blazjerman/ESP32-Based-Sensor-PCB/(commit log)

2025-01-21 Added buck converters.
    [ESP32-Based Sensor PCB.kicad_sch]
2025-01-21 Added rs485 ic and micro usb port.
    [ESP32-Based Sensor PCB.kicad_pcb, ESP32-Based Sensor PCB.kicad_sch]
2025-01-21 Added rs485 protection diodes
    [ESP32-Based Sensor PCB.kicad_sch, buck_3.3v.kicad_sch]
2025-01-21 Scheme done.
    [ESP32-Based Sensor PCB.kicad_pcb, ESP32-Based Sensor PCB.kicad_sch, buck_3.3v.kicad_sch, buck_5v.kicad_sch]
2025-01-22 Changed led resistor values and added jlcpcb fabrication.
    [ESP32-Based Sensor PCB.kicad_pcb, ESP32-Based Sensor PCB.kicad_sch]
2025-01-22 Added sound probe, 9v booster and change 3.3v buck to linear.
    [9V_Booster.kicad_sch, ESP32-Based Sensor PCB.kicad_pcb, ESP32-Based Sensor PCB.kicad_sch]
2025-01-22 The basic PCB wiring and layout have been completed.
    [9V_Booster.kicad_sch, ESP32-Based Sensor PCB.kicad_pcb, ESP32-Based Sensor PCB.kicad_sch]
2025-01-22 Changed the position of the 9V booster.
    [ESP32-Based Sensor PCB.kicad_pcb]
2025-01-22 Added 5v capacitor and improved 9v power line.
    [ESP32-Based Sensor PCB.kicad_pcb, ESP32-Based Sensor PCB.kicad_sch]
2025-01-22 Improved some power lanes.
    [ESP32-Based Sensor PCB.kicad_pcb]
2025-01-23 Added an electrolytic capacitor, one more RGB LED, and changed the booster position and traces.
    [9V_Booster.kicad_sch, ESP32-Based Sensor PCB.kicad_pcb, ESP32-Based Sensor PCB.kicad_sch]
2025-01-23 Fixed issues with the CH340C V3 connection pin and improved wiring.
    [ESP32-Based Sensor PCB.kicad_pcb, ESP32-Based Sensor PCB.kicad_sch]
2025-01-23 Added top gnd plane and fixed rgb led power problem.
    [9V_Booster.kicad_sch, ESP32-Based Sensor PCB.kicad_pcb, ESP32-Based Sensor PCB.kicad_sch]
2025-01-23 Fixed some pcb conection errors.
    [ESP32-Based Sensor PCB.kicad_pcb]
2025-01-23 Improved linear dropper heat dissipation and added the Innorenew logo.
    [ESP32-Based Sensor PCB.kicad_pcb]
2025-01-24 Fixed resistor size.
    [ESP32-Based Sensor PCB.kicad_pcb]
2025-01-24 Replaced the PNP transistor and added additional capacitors for improved stability.
    [ESP32-Based Sensor PCB.kicad_pcb, ESP32-Based Sensor PCB.kicad_sch]
2025-01-24 Improved wiring and added a USB input capacitor.
    [ESP32-Based Sensor PCB.kicad_pcb, ESP32-Based Sensor PCB.kicad_sch]
2025-01-25 Added light sensor.
    [ESP32-Based Sensor PCB.kicad_pcb, ESP32-Based Sensor PCB.kicad_sch]
2025-01-25 Change 9v booster inductor.
    [9V_Booster.kicad_sch, ESP32-Based Sensor PCB.kicad_pcb]
2025-01-25 Added 9V inductor footprint.
    [9V_Booster.kicad_sch, ESP32-Based Sensor PCB.kicad_pcb]
2025-01-25 Fixed USB differential pair.
    [ESP32-Based Sensor PCB.kicad_pcb, ESP32-Based Sensor PCB.kicad_sch]
2025-01-26 Mounting holes have been added.
    [ESP32-Based Sensor PCB.kicad_pcb, ESP32-Based Sensor PCB.kicad_sch]
2025-01-27 Made some changes and added JLC IDs to most parts.
    [9V_Booster.kicad_sch, ESP32-Based Sensor PCB.kicad_pcb, ESP32-Based Sensor PCB.kicad_sch]
2025-01-27 Change 9v booster.
    [9V_Booster.kicad_sch, ESP32-Based Sensor PCB.kicad_pcb]
2025-01-27 Improved some connections and added more labels.
    [ESP32-Based Sensor PCB.kicad_pcb]
2025-01-28 Corrected swapped wrong order of UART to RS485.
    [ESP32-Based Sensor PCB.kicad_pcb, ESP32-Based Sensor PCB.kicad_sch]
2025-01-28 Removed one RGB led.
    [ESP32-Based Sensor PCB.kicad_pcb, ESP32-Based Sensor PCB.kicad_sch]
2025-01-28 Changed some resistor values and fidex coil output.
    [9V_Booster.kicad_sch, ESP32-Based Sensor PCB.kicad_pcb, ESP32-Based Sensor PCB.kicad_sch]
2025-01-28 Changed some ics values.
    [9V_Booster.kicad_sch, ESP32-Based Sensor PCB.kicad_pcb, ESP32-Based Sensor PCB.kicad_sch]
2025-01-28 Changed RGB circuit.
    [ESP32-Based Sensor PCB.kicad_pcb, ESP32-Based Sensor PCB.kicad_sch]
2025-01-30 Changed serial pins and rgb led resistor.
    [ESP32-Based Sensor PCB.kicad_pcb, ESP32-Based Sensor PCB.kicad_sch]
2025-01-30 Added pcb test code.
    [ESP32-Based Sensor PCB.kicad_pcb]
2025-02-01 Changed rgb led resistor values
    [ESP32-Based Sensor PCB.kicad_pcb, ESP32-Based Sensor PCB.kicad_sch]
2025-02-01 Added temt6000x01 analog light sensor.
    [ESP32-Based Sensor PCB.kicad_pcb, ESP32-Based Sensor PCB.kicad_sch]
2025-02-01 Added cap to analog light sensor.
    [ESP32-Based Sensor PCB.kicad_pcb, ESP32-Based Sensor PCB.kicad_sch]
2025-02-02 Replaced two series 10k resistors with a single 20k resistor.
    [9V_Booster.kicad_sch, ESP32-Based Sensor PCB.kicad_pcb]
2025-02-03 Removed i2c light sensor and changed fuse.
    [ESP32-Based Sensor PCB.kicad_pcb, ESP32-Based Sensor PCB.kicad_sch]
2025-02-03 Impoved some connections.
    [ESP32-Based Sensor PCB.kicad_pcb, ESP32-Based Sensor PCB.kicad_sch]
2025-02-03 Changed pcb photo.
    [ESP32-Based Sensor PCB.kicad_pcb]
2025-02-04 Fixed i2c and added led pmw.
    [main.c]
2025-02-05 Change sound sensor comunication from analog to uart and improved testing.
    [ESP32-Based Sensor PCB.kicad_pcb, ESP32-Based Sensor PCB.kicad_sch]
2025-02-05 Changed the CH340C reference voltage.
    [9V_Booster.kicad_sch, ESP32-Based Sensor PCB.kicad_pcb, ESP32-Based Sensor PCB.kicad_sch]
2025-02-05 Improved thermal reliefs.
    [ESP32-Based Sensor PCB.kicad_pcb]
2025-02-05 Changed WROOM32-D to WROOM32-E.
    [ESP32-Based Sensor PCB.kicad_pcb, ESP32-Based Sensor PCB.kicad_sch]
2025-02-05 Changed jlcpcb WROOM32 part id.
    [ESP32-Based Sensor PCB.kicad_sch]
2025-02-05 Change rs485 ic.
    [ESP32-Based Sensor PCB.kicad_pcb, ESP32-Based Sensor PCB.kicad_sch]
2025-02-06 Optimized the count of different components.
    [9V_Booster.kicad_sch, ESP32-Based Sensor PCB.kicad_pcb, ESP32-Based Sensor PCB.kicad_sch]
2025-02-06 Changed some ic-s jlcpcb part.
    [ESP32-Based Sensor PCB.kicad_pcb, ESP32-Based Sensor PCB.kicad_sch]
2025-02-06 Corrected ch340c RX TX pins.
    [ESP32-Based Sensor PCB.kicad_pcb, ESP32-Based Sensor PCB.kicad_sch]
2025-02-21 Removed the IO0 capacitor and optimized a few lines.
    [ESP32-Based Sensor PCB.kicad_pcb, ESP32-Based Sensor PCB.kicad_sch]
2025-02-21 Improved I2C multiplexer wiring.
    [ESP32-Based Sensor PCB.kicad_pcb]
2025-02-21 Improved wiring.
    [ESP32-Based Sensor PCB.kicad_pcb]
2025-02-21 Updated PCB picture.
2025-02-27 Changed TEMT6000X01 resistor back to original size and fixed wrong part number for CH340C.
    [ESP32-Based Sensor PCB.kicad_pcb, ESP32-Based Sensor PCB.kicad_sch]
2025-02-28 Improved differential pair connection and updated PCB version.
    [ESP32-Based Sensor PCB.kicad_pcb]
2025-02-28 Minor corrections.
    [ESP32-Based Sensor PCB.kicad_pcb]
2025-03-01 Minor changes.
    [ESP32-Based Sensor PCB.kicad_pcb]
2025-03-05 Improved terminal block and added enable/disable 9v booster.
    [9V_Booster.kicad_sch, ESP32-Based Sensor PCB.kicad_pcb, ESP32-Based Sensor PCB.kicad_sch]
2025-03-05 Change the electrolytic capacitor value and the 9V booster enable resistor.
    [9V_Booster.kicad_sch, ESP32-Based Sensor PCB.kicad_pcb, ESP32-Based Sensor PCB.kicad_sch]
2025-03-08 Changed the inductor and added the JLC ID for the terminal blocks.
    [9V_Booster.kicad_sch, ESP32-Based Sensor PCB.kicad_pcb, ESP32-Based Sensor PCB.kicad_sch]
2025-03-08 Removed unused library parts and updated the version.
    [ESP32-Based Sensor PCB.kicad_pcb]
2025-04-02 Added arduino ide pcb testing.
2025-04-05 Improved sound sensor rx tx connection.
    [ESP32-Based Sensor PCB.kicad_pcb]
2025-04-05 Improved sound sensor rx tx connection again.
    [ESP32-Based Sensor PCB.kicad_pcb]
2025-04-14 Added button.
    [ESP32-Based Sensor PCB.kicad_pcb]
2025-04-14 Added JLCPCB button part, improved wiring, and updated the picture.
    [ESP32-Based Sensor PCB.kicad_pcb, ESP32-Based Sensor PCB.kicad_sch]
2025-04-14 Changed EN, BOOT pin size and improved wiring.
    [ESP32-Based Sensor PCB.kicad_pcb, ESP32-Based Sensor PCB.kicad_sch]
2025-04-14 Renamed general-purpose pin from ANA to GP.
    [ESP32-Based Sensor PCB.kicad_pcb, ESP32-Based Sensor PCB.kicad_sch]
2025-04-23 Moved button.
    [ESP32-Based Sensor PCB.kicad_pcb]
2025-04-30 Fixed wrong position of decopling capacitor for CH340C
    [ESP32-Based Sensor PCB.kicad_pcb]
2025-04-30 Added decoupling capacitor for CH340C 3v
    [ESP32-Based Sensor PCB.kicad_pcb, ESP32-Based Sensor PCB.kicad_sch]
2025-05-22 Changed light sensor to use dhc1 instead of dhc2
    [ESP32-Based Sensor PCB.kicad_pcb, ESP32-Based Sensor PCB.kicad_sch]
2025-05-22 Changed JLC id to some basic components.
    [9V_Booster.kicad_sch, ESP32-Based Sensor PCB.kicad_pcb, ESP32-Based Sensor PCB.kicad_sch]
2025-05-23 Added arduino test for MHT04
2025-05-27 Changed esp32 bord from N4 to N8.
    [ESP32-Based Sensor PCB.kicad_pcb, ESP32-Based Sensor PCB.kicad_sch]
2025-05-28 Improved some connections
    [ESP32-Based Sensor PCB.kicad_pcb]
2025-08-25 Changed rs ic and tvs.
    [ESP32-Based Sensor PCB.kicad_pcb, ESP32-Based Sensor PCB.kicad_sch]
2026-03-09 Added rs ic missing resistor
    [ESP32-Based Sensor PCB.kicad_pcb, ESP32-Based Sensor PCB.kicad_sch]
2026-07-23 Removed 100uF capacitor from vbus and changed 3.3v regulator ic
    [3.3V_buck.kicad_sch, 9V_Booster.kicad_sch, ESP32-Based Sensor PCB.kicad_pcb, ESP32-Based Sensor PCB.kicad_sch]
2026-07-23 updated some parts
    [3.3V_buck.kicad_sch, 9V_Booster.kicad_sch, ESP32-Based Sensor PCB.kicad_pcb, ESP32-Based Sensor PCB.kicad_sch]
2026-07-23 Updated revision to 1.2.3
    [ESP32-Based Sensor PCB.kicad_pcb, ESP32-Based Sensor PCB.kicad_sch]
2026-07-24 Changed reset button
    [ESP32-Based Sensor PCB.kicad_pcb, ESP32-Based Sensor PCB.kicad_sch]
2026-07-24 Changed 3.3v bulk capacitors from 4.7uF to 10uF
    [3.3V_buck.kicad_sch, ESP32-Based Sensor PCB.kicad_pcb, ESP32-Based Sensor PCB.kicad_sch]
2026-07-24 Moved button
    [ESP32-Based Sensor PCB.kicad_pcb]
